Manyullyn17/UwU-Bot/UwU-Bot Präsentation.pptx

## UwU-Bot

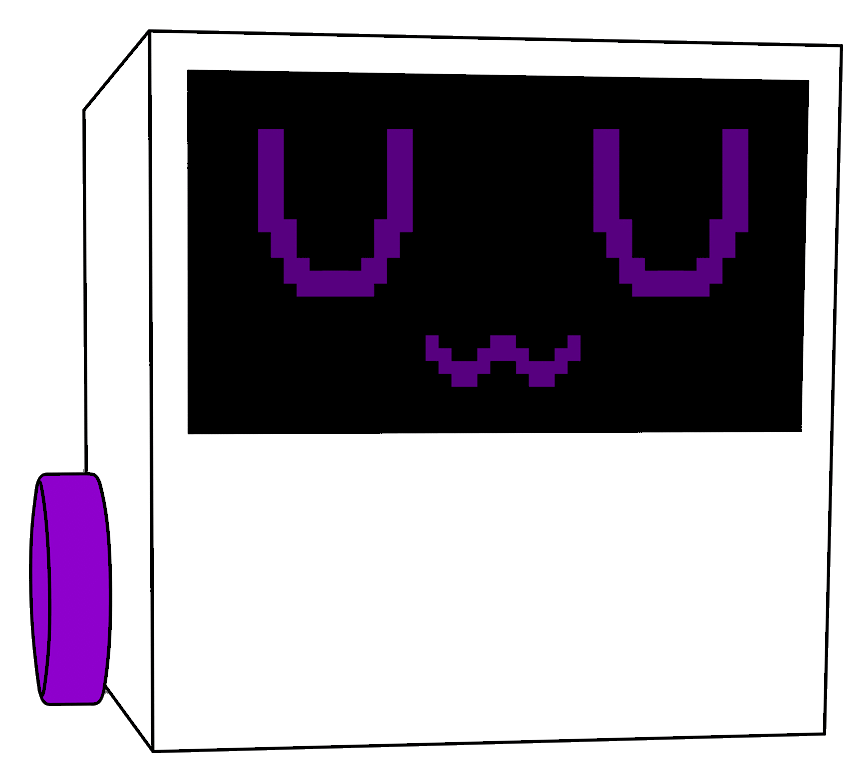
[picture p33: figure]

By Nico Huber, Lukas-Gerald Greiss
& Manuel Greiler

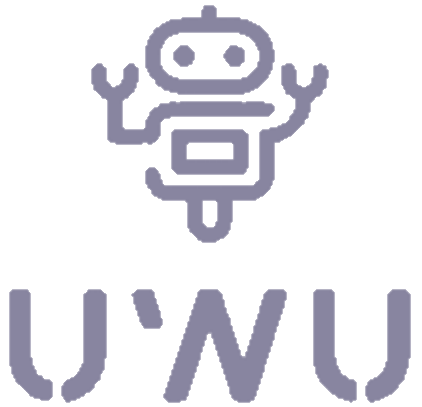
[picture p34: figure]

## Übersicht

- Android App
  - Joysticks & Senden der Daten
- Datenübertragung und Verarbeitung
  - Empfang & Verarbeitung der Daten
- Fahrwerk
  - Motoren, Ansteuerung, Räder und Lenkung

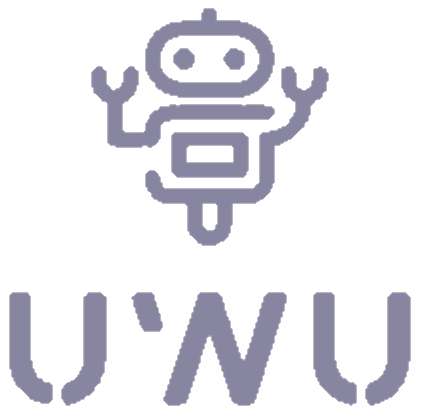
[picture p35: figure]

Manuel Greiler

## Joysticks

- Zwei Joysticks zum Steuern der Räder
  - Jeweils für linkes und rechtes Rad
- Selbst implementiert, von „View“ abgeleitet
- Können hoch und runter bewegt werden
- Werte von -100 bis 100 Prozent
  - Werden auf nächste Fünf gerundet

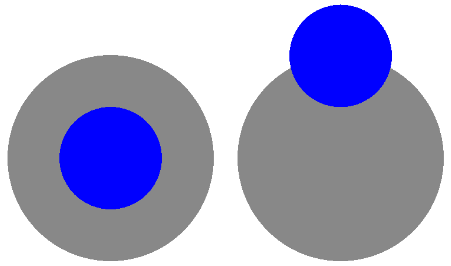
[picture p36: figure]

Manuel Greiler

## Senden der Daten

- Bluetooth Classic 4.0
- Daten zur Übertragung:
  - Position der Joysticks in Prozent
  - Gesichts ID
- Einweg-Kommunikation

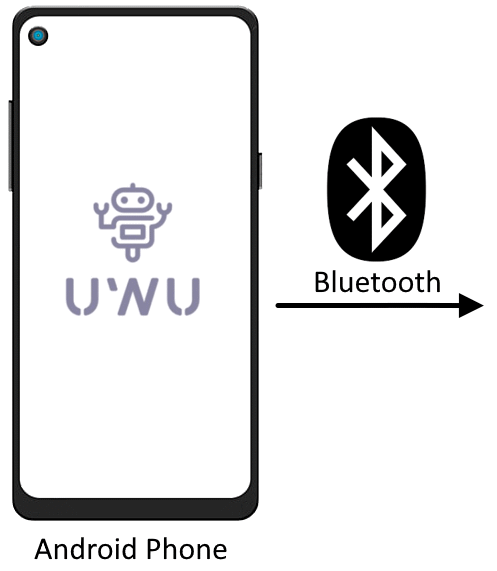
[picture p37: figure]
Datenübertragung von Android Smartphone zu ESP32

Manuel Greiler

## Bluetooth Bibliothek

- Android-Bluetooth-Serial
- Einfach mit Gerät verbinden
  - Verfügbare Geräte auflisten
  - Per Name oder MAC-Adresse verbinden
- Einfach Daten senden und empfangen
- Feedback bei erfolgreicher Verbindung, Daten senden und empfangen

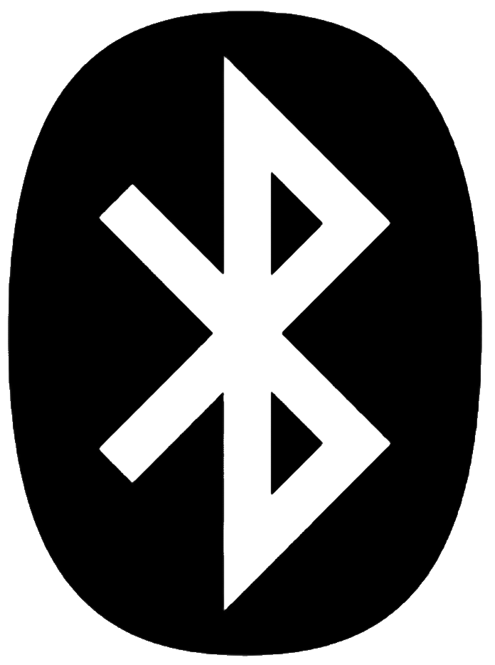
[picture p38: figure]
Bluetooth Logo

Manuel Greiler

## Slide 6

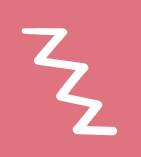
[picture p39: figure]

Empfang der Daten

- BluetoothSerial Bibliothek
- Daten als String eingelesen
- String muss weiter verarbeitet werden

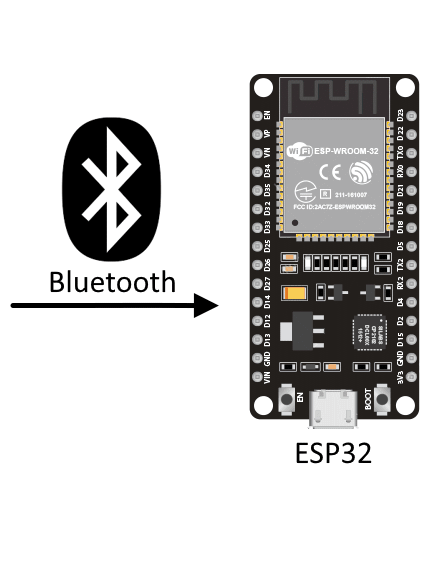
[picture p40: figure]
Datenübertragung von Android Smartphone zu ESP32

Manuel Greiler

## Slide 7

Verarbeitung der Daten

- String besteht aus Befehl und Wert
- Befehl und Wert werden getrennt
- Befehl (char) gibt an welche Funktion ausgeführt werden soll
- Wert (int) gibt den Wert für die Funktion an
  - Muss gegebenenfalls umgerechnet werden

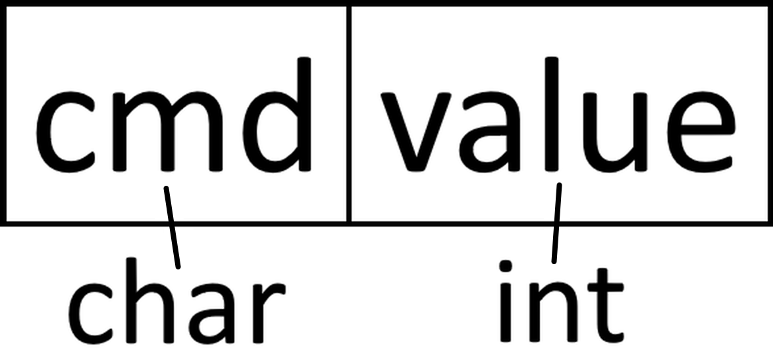
[picture p41: figure]
Datenpacket

Manuel Greiler

## Slide 8

Befehle

- L/R – setzt Geschwindigkeit vom linken/rechten Rad
  - Wert von Prozent zu Schritte pro Sekunde umrechnen
  - Max. Geschwindigkeit im Code festgelegt
  - Ergebnis an setSpeed() weitergegeben
- F – ändert am Display angezeigtes Gesicht
  - Wert an drawFace() weitergegeben

Manuel Greiler

## Motoren

- Zwei Schrittmotoren
- Präzise & schnell
- Leistungsstark
- Räder direkt an Achse befestigt
- Ansteuerung mit Treiber


Manuel Greiler

## Schrittmotor-Treiber

- Erleichtert Ansteuerung der Motoren
- Nur 2 Pins pro Motor am ESP32
- Unterstützt Microstepping
  - Erlaubt kleinere Schritte
  - Weniger Vibrationen
  - Verringertes Dreh- und Haltemoment

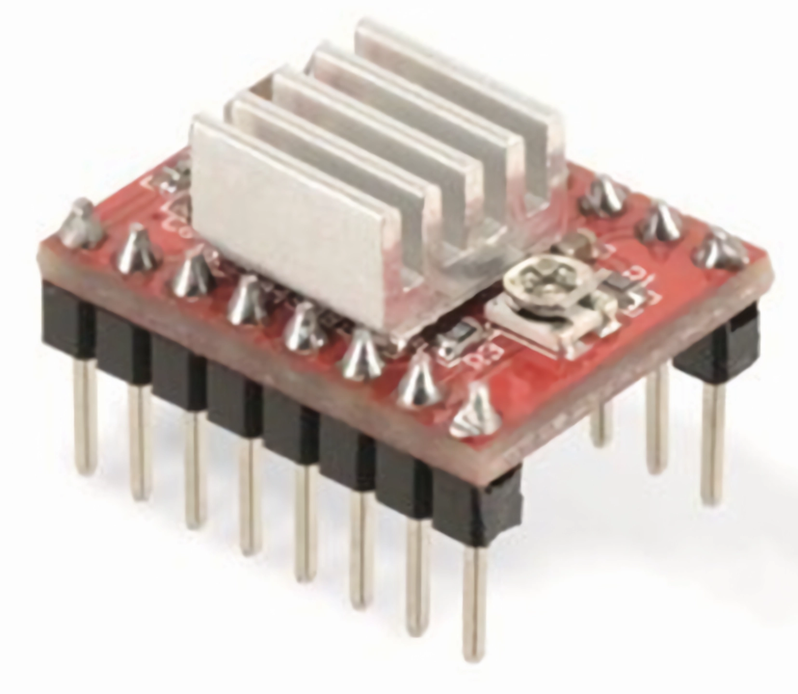
[picture p42: figure]

Manuel Greiler

## Ansteuerung mit ESP32

- AccelStepper Bibliothek
  - Funktionen zur einfachen Ansteuerung von Schrittmotoren und Treibern
- setSpeed() setzt Drehgeschwindigkeit des Motors
- runSpeed() so oft wie möglich aufrufen, um Treiber Step-Pulse zu senden

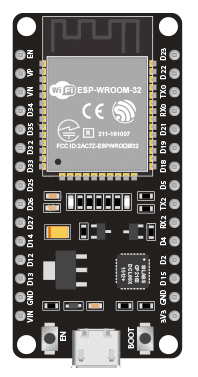
[picture p43: figure]

Manuel Greiler

## Multitasking

- ESP32 hat zwei Kerne
- Können parallel Aufgaben ausführen
- Ein Kern kann runSpeed() aufrufen
- Anderer Kern kümmert sich um restliche notwendige Funktionen
- Sonst wird runSpeed() nicht oft genug aufgerufen -> Motoren funktionieren nicht

Multitasking ESP32 - Kerne

Manuel Greiler

## Lenkung

- Zwei fixe Räder -> Panzersteuerung
- Räder können sich unabhängig voneinander drehen
- Ein Rad schneller als das andere
-> Lenken
- Entgegengesetzte Richtung
-> an der Stelle drehen


Manuel Greiler

## Slide 14

Räder

- Zwei Hinterräder
- 3D modelliert und gedruckt
- Aus PLA-Kunststoff
- Profil zur besseren Haftung
- Vorne zwei omnidirektionale Möbelrollen


Manuel Greiler

## Slide 15

Fin
