Manyullyn17/UwU-Bot/pictures/2023-03-15 17_34_24-Diplomarbeits-DB __ Arbeit Progress - Opera.png

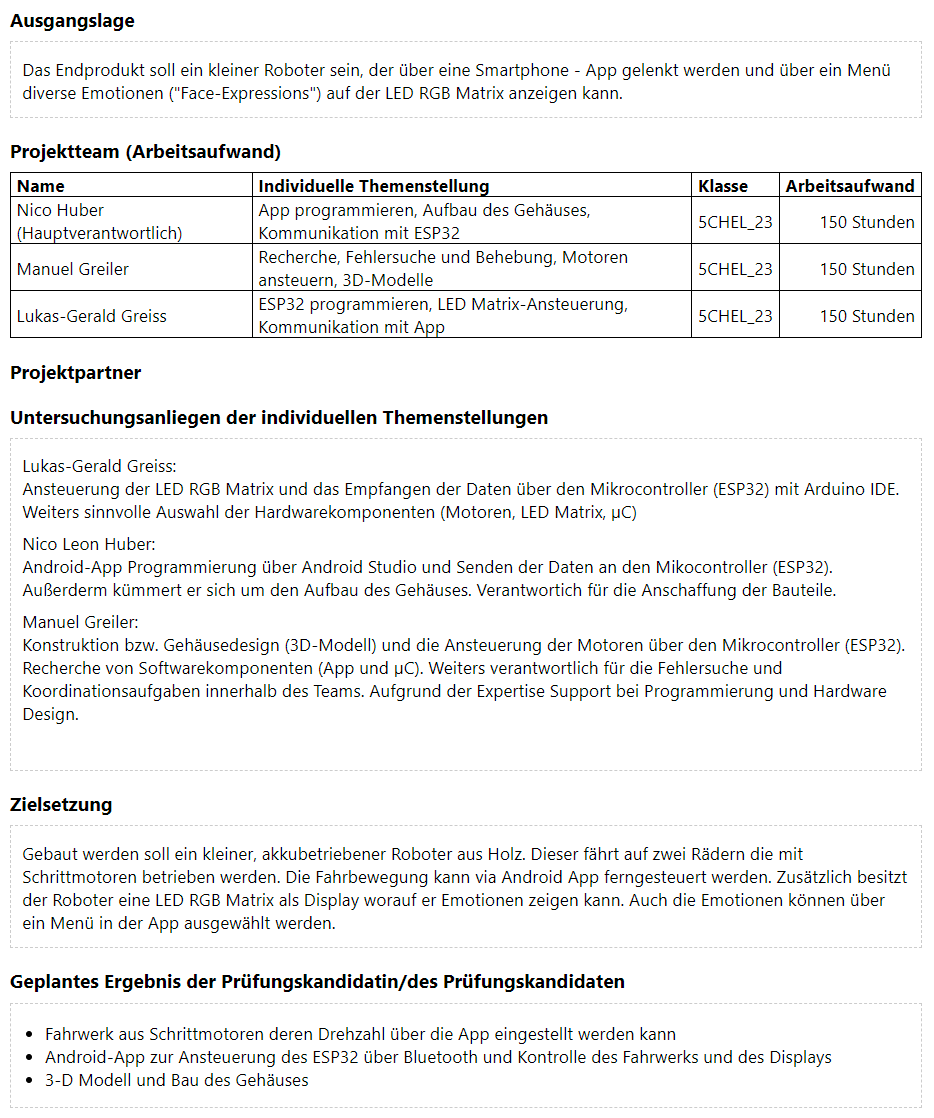
pictures/2023-03-15 17_34_24-Diplomarbeits-DB __ Arbeit Progress - Opera.png
