Manyullyn17/UwU-Bot/pictures/Display Pins.png

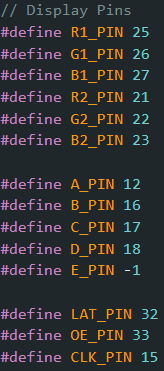
pictures/Display Pins.png
