Manyullyn17/UwU-Bot/pictures/faces/Angry Face hires.png

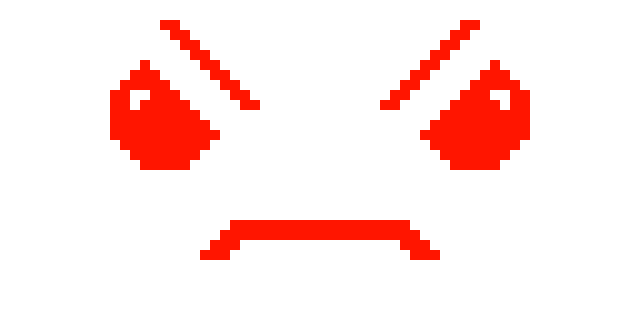
pictures/faces/Angry Face hires.png
