Manyullyn17/UwU-Bot/pictures/faces/happy face hires.png

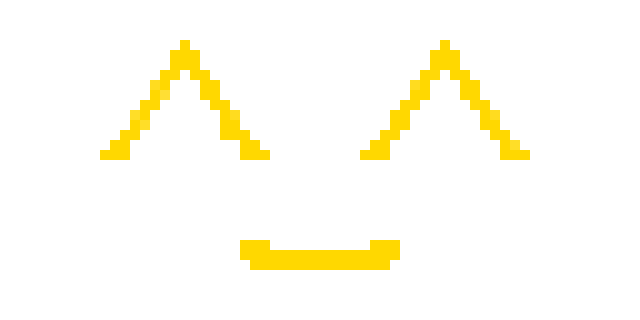
pictures/faces/happy face hires.png
