Manyullyn17/UwU-Bot/pictures/faces/love face hires.png

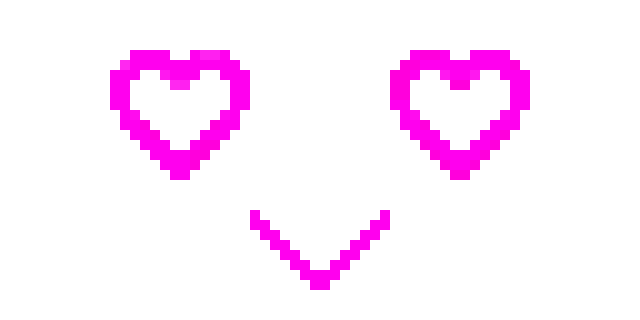
pictures/faces/love face hires.png
