Manyullyn17/UwU-Bot/pictures/faces/sad face2.0 hires.png

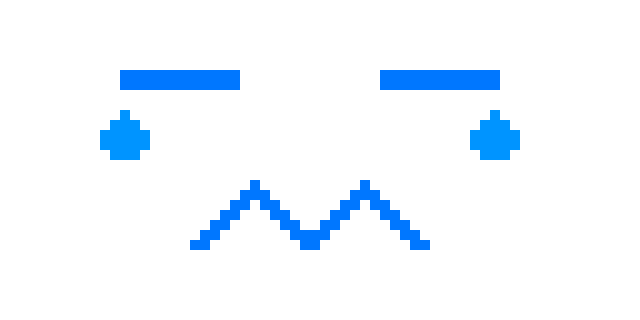
pictures/faces/sad face2.0 hires.png
