Manyullyn17/UwU-Bot/pictures/faces/scared face hires.png

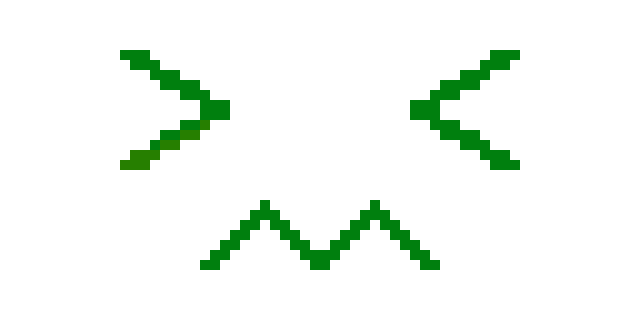
pictures/faces/scared face hires.png
