Manyullyn17/UwU-Bot/pictures/faces/sleepy face hires.png

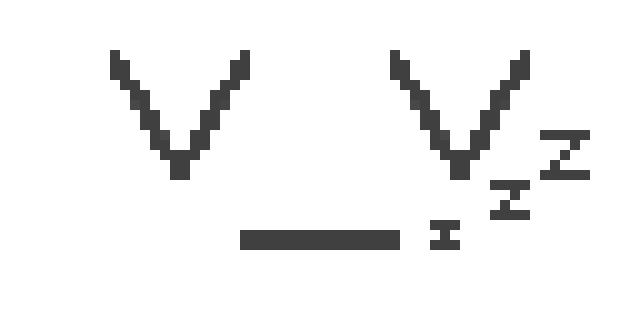
pictures/faces/sleepy face hires.png
