Manyullyn17/UwU-Bot/pictures/faces/suprised face hires.png

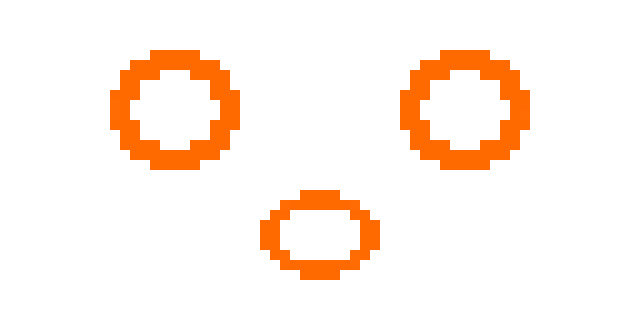
pictures/faces/suprised face hires.png
