Manyullyn17/UwU-Bot/pictures/faces/UwU face hires.png

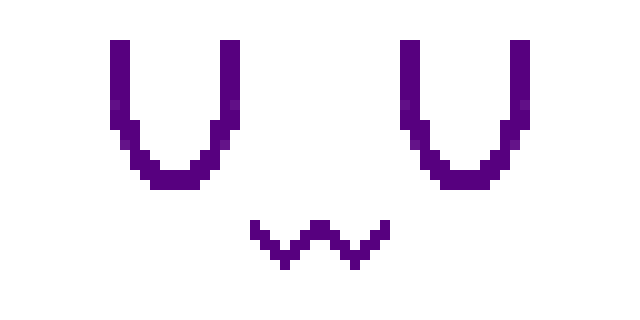
pictures/faces/UwU face hires.png
