Manyullyn17/UwU-Bot/Eagle/UwU-Bot/UwU Bot.brd

## EAGLE design Eagle/UwU-Bot/UwU Bot.brd (2023-04-20, an earlier design)

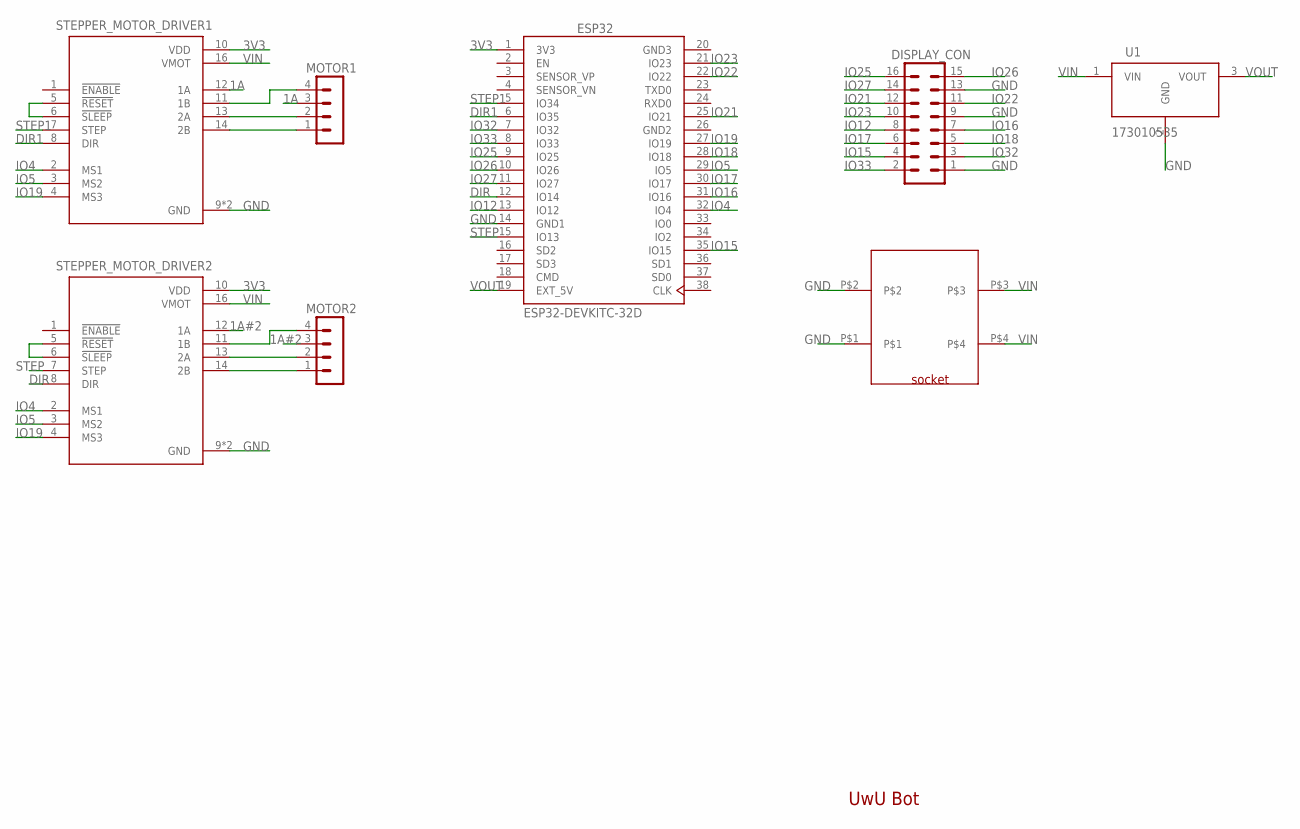
[picture p54: schematic UwU Bot.sch]

Parts:
DISPLAY_CON: MA08-2
ESP32: ESP32-DEVKITC-32D; MODULE_ESP32-DEVKITC-32D
MOTOR1, MOTOR2: MA04-1
STEPPER_MOTOR_DRIVER1, STEPPER_MOTOR_DRIVER2: A4988_STEPPER_MOTOR_DRIVER_CARRIER_BLACK; MODULE_A4988_STEPPER_MOTOR_DRIVER_CARRIER_BLACK
U1: 173010535
U$1: BUCHSEDC; BUCHSE

Connections:
1A: MOTOR1.3, STEPPER_MOTOR_DRIVER1.12 (1A)
1A#2: MOTOR2.3, STEPPER_MOTOR_DRIVER2.12 (1A)
3V3: ESP32.1 (3V3), STEPPER_MOTOR_DRIVER1.10 (VDD), STEPPER_MOTOR_DRIVER2.10 (VDD)
DIR: ESP32.12 (IO14), STEPPER_MOTOR_DRIVER2.8 (DIR)
DIR1: ESP32.6 (IO35), STEPPER_MOTOR_DRIVER1.8 (DIR)
GND: DISPLAY_CON.1, DISPLAY_CON.9, DISPLAY_CON.13, ESP32.14 (GND1), STEPPER_MOTOR_DRIVER1.9 (GND), STEPPER_MOTOR_DRIVER1.15 (GND), STEPPER_MOTOR_DRIVER2.9 (GND), STEPPER_MOTOR_DRIVER2.15 (GND), U1.2 (GND), U$1.P$1, U$1.P$2
GND2: ESP32.26 (GND2)
GND3: ESP32.20 (GND3)
IO4: ESP32.32 (IO4), STEPPER_MOTOR_DRIVER1.2 (MS1), STEPPER_MOTOR_DRIVER2.2 (MS1)
IO5: ESP32.29 (IO5), STEPPER_MOTOR_DRIVER1.3 (MS2), STEPPER_MOTOR_DRIVER2.3 (MS2)
IO12: DISPLAY_CON.8, ESP32.13 (IO12)
IO15: DISPLAY_CON.4, ESP32.35 (IO15)
IO16: DISPLAY_CON.7, ESP32.31 (IO16)
IO17: DISPLAY_CON.6, ESP32.30 (IO17)
IO18: DISPLAY_CON.5, ESP32.28 (IO18)
IO19: ESP32.27 (IO19), STEPPER_MOTOR_DRIVER1.4 (MS3), STEPPER_MOTOR_DRIVER2.4 (MS3)
IO21: DISPLAY_CON.12, ESP32.25 (IO21)
IO22: DISPLAY_CON.11, ESP32.22 (IO22)
IO23: DISPLAY_CON.10, ESP32.21 (IO23)
IO25: DISPLAY_CON.16, ESP32.9 (IO25)
IO26: DISPLAY_CON.15, ESP32.10 (IO26)
IO27: DISPLAY_CON.14, ESP32.11 (IO27)
IO32: DISPLAY_CON.3, ESP32.7 (IO32)
IO33: DISPLAY_CON.2, ESP32.8 (IO33)
unnamed: MOTOR1.4, STEPPER_MOTOR_DRIVER1.11 (1B)
unnamed: STEPPER_MOTOR_DRIVER1.5 (!RESET), STEPPER_MOTOR_DRIVER1.6 (!SLEEP)
unnamed: STEPPER_MOTOR_DRIVER2.5 (!RESET), STEPPER_MOTOR_DRIVER2.6 (!SLEEP)
unnamed: MOTOR2.4, STEPPER_MOTOR_DRIVER2.11 (1B)
unnamed: MOTOR2.2, STEPPER_MOTOR_DRIVER2.13 (2A)
unnamed: MOTOR2.1, STEPPER_MOTOR_DRIVER2.14 (2B)
unnamed: MOTOR1.1, STEPPER_MOTOR_DRIVER1.14 (2B)
unnamed: MOTOR1.2, STEPPER_MOTOR_DRIVER1.13 (2A)
STEP: ESP32.15 (IO13), STEPPER_MOTOR_DRIVER2.7 (STEP)
STEP1: ESP32.5 (IO34), STEPPER_MOTOR_DRIVER1.7 (STEP)
VIN: STEPPER_MOTOR_DRIVER1.16 (VMOT), STEPPER_MOTOR_DRIVER2.16 (VMOT), U1.1 (VIN), U$1.P$3, U$1.P$4
VOUT: ESP32.19 (EXT_5V), U1.3 (VOUT)

Notes on the sheet:
UwU Bot

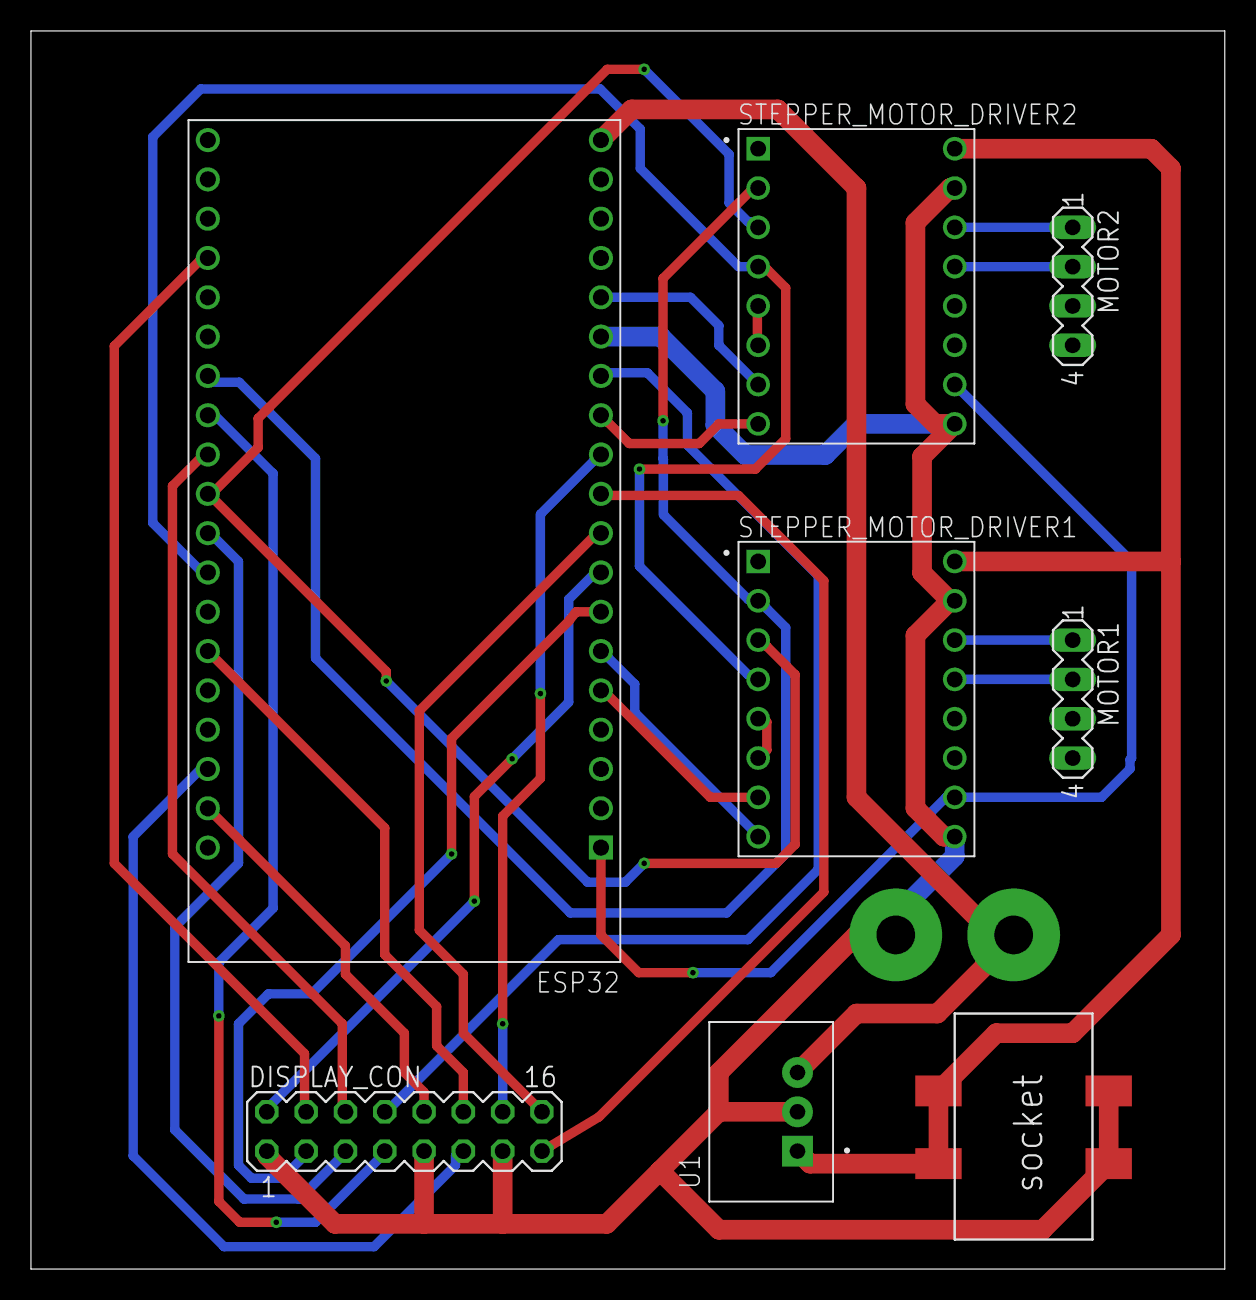
[picture p55: board UwU Bot.brd from above]

Board: 2 copper layers, 77.1 x 80.0 mm, 8 parts (0 on the bottom side), 34 nets.
