Manyullyn17/UwU-Bot/arduino/UwU-Bot_Control_V1/UwU-Bot_Control_V1.ino

#include <Adafruit_GFX.h>     // Core Graphics Library
#include <BluetoothSerial.h>  // Bluetooth Library
#include <AccelStepper.h>     // StepperMotor Controller Library
#include <ESP32-HUB75-MatrixPanel-I2S-DMA.h>
#include <ESP32-VirtualMatrixPanel-I2S-DMA.h>

#define RMOTOR_DIR_PIN 2
#define RMOTOR_STEP_PIN 4

#define LMOTOR_DIR_PIN 14
#define LMOTOR_STEP_PIN 13

#define MAX_SPEED 500  // max speed for motors

#define MS1_PIN 0
#define MS2_PIN 5
#define MS3_PIN 19

// Display Pins
#define R1_PIN 25
#define G1_PIN 26
#define B1_PIN 27
#define R2_PIN 21
#define G2_PIN 22
#define B2_PIN 23

#define A_PIN 12
#define B_PIN 16
#define C_PIN 17
#define D_PIN 18
#define E_PIN -1

#define LAT_PIN 32
#define OE_PIN 33
#define CLK_PIN 15

AccelStepper rmotor(AccelStepper::DRIVER, RMOTOR_STEP_PIN, RMOTOR_DIR_PIN);
AccelStepper lmotor(AccelStepper::DRIVER, LMOTOR_STEP_PIN, LMOTOR_DIR_PIN);

HUB75_I2S_CFG::i2s_pins _pins = { R1_PIN, G1_PIN, B1_PIN, R2_PIN, G2_PIN, B2_PIN, A_PIN, B_PIN, C_PIN, D_PIN, E_PIN, LAT_PIN, OE_PIN, CLK_PIN };
HUB75_I2S_CFG mxconfig(
  64,     // Module width
  32,     // Module height
  1,      // chain length
  _pins  // pin mapping
);
MatrixPanel_I2S_DMA *dma_display = new MatrixPanel_I2S_DMA(mxconfig);

BluetoothSerial ESP_BT;

TaskHandle_t MotorDriver;  // task to drive motors

const unsigned char UwU[] PROGMEM = {
  // 'UwU face', 64x32px
  0x00, 0x00, 0x00, 0x00, 0x00, 0x00, 0x00, 0x00, 0x00, 0x00, 0x00, 0x00, 0x00, 0x00, 0x00, 0x00,
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
      break;

    default:  // default = UwU
      dma_display->drawBitmap(0, 0, UwU, 64, 32, dma_display->color444(15, 0, 15));
      break;
  }
}

void motorRun(void* parameter)  // Task to run motors (runs on separate core)
{
  while (true) {
    rmotor.runSpeed();
    lmotor.runSpeed();
  }
}

void setup() {
  ESP_BT.begin("ESP32");  // set the name of the device

  rmotor.setMaxSpeed(MAX_SPEED);
  lmotor.setMaxSpeed(MAX_SPEED);
  rmotor.setSpeed(0);
  lmotor.setSpeed(0);

  xTaskCreatePinnedToCore(  // run Task motorDriver on Core 0
    motorRun,               // Function to implement the task
    "MotorDriver",          // Name of the task
    10000,                  // Stack size in words
    NULL,                   // Task input parameter
    0,                      // Priority of the task
    &MotorDriver,           // Task handle
    0);                     // Core where the task should run


  pinMode(MS1_PIN, OUTPUT);
  pinMode(MS2_PIN, OUTPUT);
  pinMode(MS3_PIN, OUTPUT);

  // Microstepping
  digitalWrite(MS1_PIN, LOW);
  digitalWrite(MS2_PIN, HIGH);
  digitalWrite(MS3_PIN, LOW);

  dma_display->begin();
  dma_display->setBrightness(90); // 0-255
  dma_display->drawBitmap(0, 0, UwU, 64, 32, dma_display->color444(15, 0, 15)); // draw default Face
}

void loop() {
  if (ESP_BT.available()) {
    String incomingData = ESP_BT.readStringUntil('\0');  // read incoming data

    char cmd = incomingData.charAt(0);  // get cmd from incomingData
    int face, rval, lval, rspeed, lspeed;

    incomingData.remove(0, 1);  // remove cmd from incomingData

    if (cmd == 'F') {
      face = incomingData.toInt();  // face id
      drawFace(face);
    } else if (cmd == 'R') {
      rval = incomingData.toInt();          // speed of rmotor in percent
      rspeed = (MAX_SPEED / 100.0) * rval;  // convert percent to absolute speed
      rmotor.setSpeed(rspeed);
    } else if (cmd == 'L') {
      lval = -incomingData.toInt();         // speed of lmotor in percent
      lspeed = (MAX_SPEED / 100.0) * lval;  // convert percent to absolute speed
      lmotor.setSpeed(lspeed);
    }
  }
}
