Manyullyn17/UwU-Bot/(commit log)

2023-03-16 added Eagle, ESP32 Datasheet and faces
    [UwU Bot.brd, UwU Bot.sch]
2023-03-29 added hires faces and fully featured esp32 program
2023-03-30 fixed MS1 Pin number and renamed UwU-Bot-App Folder
2023-04-20 updated Eagle
    [UwU Bot.brd, UwU Bot.sch]
2023-04-20 updated android and arduino
2023-04-20 added arduino code with new display lib and cleaned up old code
2023-04-21 fixed and improved EAGLE Layout
    [UwU Bot.brd, UwU Bot.sch]
2023-04-21 cleanup and fixed hole size
    [UwU Bot.brd]
2023-05-15 added new pictures, reorganized folder structure and removed debugging from newest version of code
    [UwU Bot.brd, UwU Bot.sch]
2023-05-15 added Steering and more to Wheels
